TinyTapeout/ttsky25a-tinyQV/fpga/generic/test/tb.v

`default_nettype none
`timescale 1ns / 1ps

/* This testbench just instantiates the module and makes some convenient wires
   that can be driven / tested by the cocotb test.py.
*/
module tb ();

  // Wire up the inputs and outputs:
  reg clk;
  reg rst_n;
  reg ena;
  reg [7:0] ui_in;
  wire [7:0] uo_out;

  // Replace tt_um_factory_test with your module name:
  tinyQV_top user_project (

      // Include power ports for the Gate Level test:
`ifdef GL_TEST
      .VPWR(1'b1),
      .VGND(1'b0),
`endif

      .ui_in  (ui_in),    // Dedicated inputs
      .uo_out (uo_out),   // Dedicated outputs
      .clk    (clk),      // clock
      .rst_n  (rst_n)     // not reset
  );

endmodule
