TinyTapeout/ttsky25a-tinyQV/(commit log)

2025-08-08 Pico-ICE FPGA build
2025-08-20 Additional full peripheral slots with no interrupt
2025-08-30 Faster multi word store, lint fixes
    [spi.v]
